raulbraghin/Floricultura/Documentos/Captura de tela de 2022-11-15 08-18-56.png

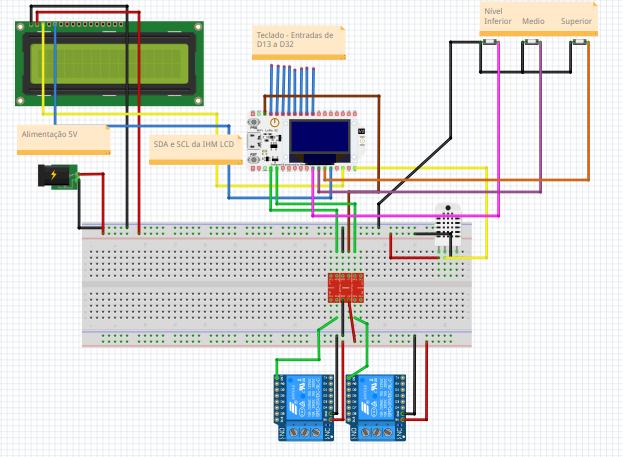
Documentos/Captura de tela de 2022-11-15 08-18-56.png
