raulbraghin/Floricultura/Documentos/Captura de tela de 2022-11-15 07-44-01.png

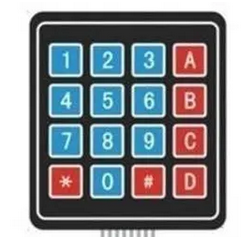
Documentos/Captura de tela de 2022-11-15 07-44-01.png
