raulbraghin/Floricultura/Documentos/Captura de tela de 2022-11-14 21-08-04.png

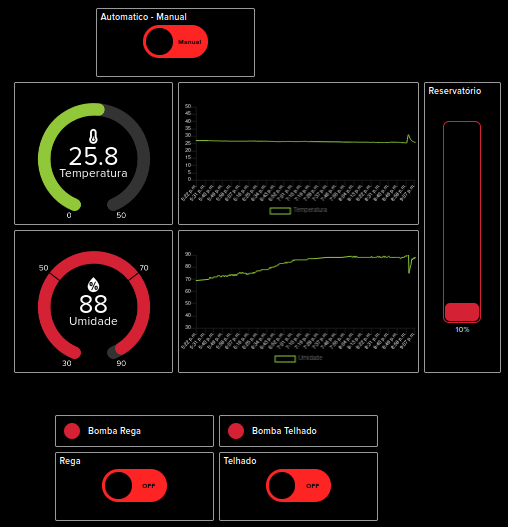
Documentos/Captura de tela de 2022-11-14 21-08-04.png
